rodlima78/rod6502/hw/addrdev_test.txt

A15 A14 A13 A12 A11 A10 A9 A8 CLK  RAM0 RAM1 ROM VIA IRQ ACIA LCD DEV4 DEV5 DEV6 DEV7
  0   0   0   0   0   0  0  0   0     1    1   1   1   1    1   0    1    1    1    1
  0   0   0   0   0   0  0  0   1     0    1   1   1   1    1   0    1    1    1    1
  0   1   1   1   1   1  1  1   0     1    1   1   1   1    1   0    1    1    1    1
  0   1   1   1   1   1  1  1   1     0    1   1   1   1    1   0    1    1    1    1

  1   0   0   0   0   0  0  0   0     1    1   1   1   1    1   0    1    1    1    1
  1   0   0   0   0   0  0  0   1     1    0   1   1   1    1   0    1    1    1    1
  1   0   1   1   1   1  1  1   0     1    1   1   1   1    1   0    1    1    1    1
  1   0   1   1   1   1  1  1   1     1    0   1   1   1    1   0    1    1    1    1

  1   1   0   0   0   0  0  0   0     1    1   1   0   1    1   0    1    1    1    1
  1   1   0   0   0   0  0  0   1     1    1   1   0   1    1   0    1    1    1    1

  1   1   0   0   0   0  0  1   0     1    1   1   1   0    1   0    1    1    1    1
  1   1   0   0   0   0  0  1   1     1    1   1   1   0    1   0    1    1    1    1

  1   1   0   0   0   0  1  0   0     1    1   1   1   1    0   0    1    1    1    1
  1   1   0   0   0   0  1  0   1     1    1   1   1   1    0   0    1    1    1    1

  1   1   0   0   0   0  1  1   0     1    1   1   1   1    1   0    1    1    1    1
  1   1   0   0   0   0  1  1   1     1    1   1   1   1    1   1    1    1    1    1

  1   1   0   0   1   0  0  0   0     1    1   0   1   1    1   0    1    1    1    1
  1   1   0   0   1   0  0  0   1     1    1   0   1   1    1   0    1    1    1    1

  1   1   0   1   0   0  0  0   0     1    1   0   1   1    1   0    1    1    1    1
  1   1   0   1   0   0  0  0   1     1    1   0   1   1    1   0    1    1    1    1

  1   1   1   0   0   0  0  0   0     1    1   0   1   1    1   0    1    1    1    1
  1   1   1   0   0   0  0  0   1     1    1   0   1   1    1   0    1    1    1    1

  1   1   1   1   1   1  1  1   0     1    1   0   1   1    1   0    1    1    1    1
  1   1   1   1   1   1  1  1   1     1    1   0   1   1    1   0    1    1    1    1
