rodlima78/rod6502/hw/symbols/ATF16V8B.step

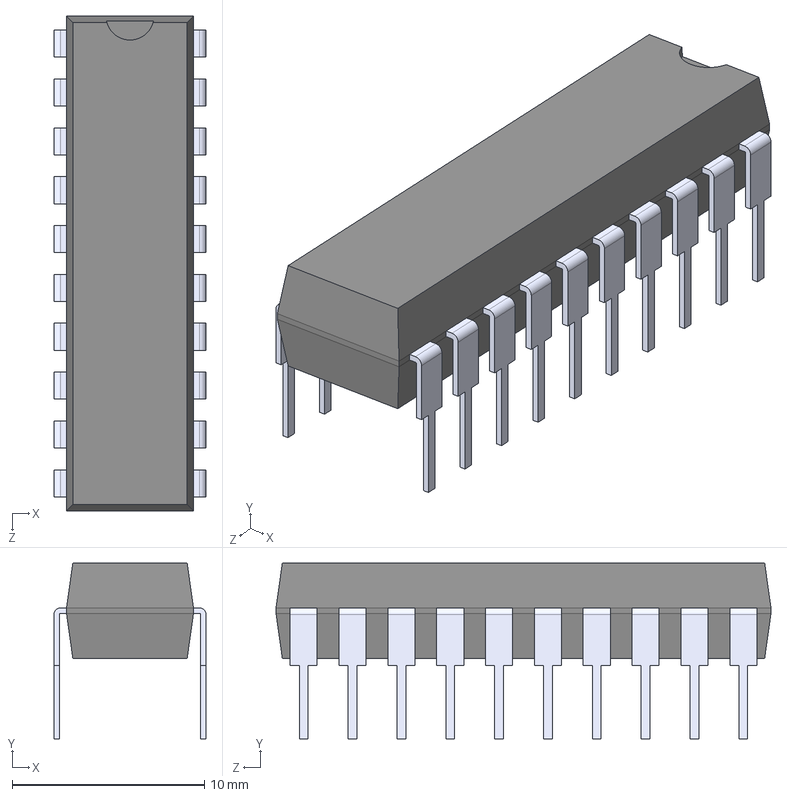
[picture p1: CAD file, 2023-03-20]
hw/symbols/ATF16V8B.step
7.90 x 9.14 x 25.7 mm
