rodlima78/rod6502/(list of files, drawings)

Other design files:
hw/addrdec.circ
hw/irq_rw.circ
hw/rw_split.circ
