rodlima78/rod6502/hw/addrdec.kicad_sch

## KiCad design hw/addrdec.kicad_sch (2023-06-03, an earlier design)

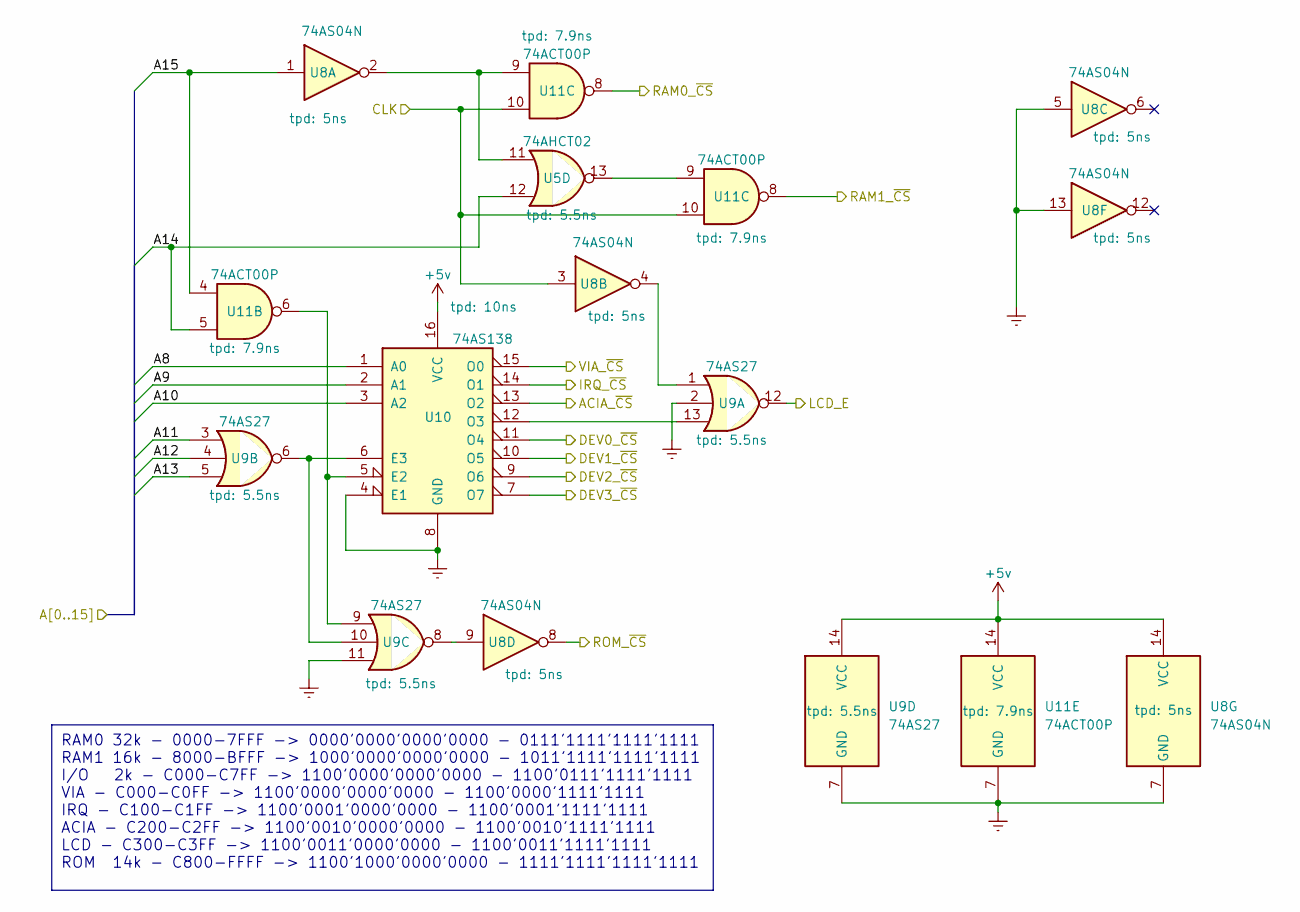
[picture p2: schematic addrdec.kicad_sch]

Parts:
U5: 74AHCT02
U8: 74AS04N
U9: 74AS27
U10: 74AS138
U11: 74ACT00P

Connections:
+5v: U8.14 (VCC), U9.14 (VCC), U10.16 (VCC), U11.14 (VCC)
A8: U10.1 (A0)
A9: U10.2 (A1)
A10: U10.3 (A2)
A11: U9.3
A12: U9.4
A13: U9.5
A14: U5.12, U11.5
A15: U8.1, U11.4
ACIA_~CS: U10.13 (O2)
CLK: U8.3, U11.10
DEV0_~CS: U10.11 (O4)
DEV1_~CS: U10.10 (O5)
DEV2_~CS: U10.9 (O6)
DEV3_~CS: U10.7 (O7)
Earth: U8.5, U8.7 (GND), U8.13, U9.2, U9.7 (GND), U9.11, U10.4 (E1), U10.8 (GND), U11.7 (GND)
IRQ_~CS: U10.14 (O1)
LCD_E: U9.12
unnamed: U8.4, U9.1
unnamed: U8.9, U9.8
unnamed: U9.9, U10.5 (E2), U11.6
unnamed: U9.6, U9.10, U10.6 (E3)
unnamed: U9.13, U10.12 (O3)
unnamed: U5.11, U5.13, U8.2, U11.9
RAM0_~CS: U11.8
RAM1_~CS: U11.8
ROM_~CS: U8.8
VIA_~CS: U10.15 (O0)

Notes on the sheet:
RAM0 32k - 0000-7FFF -> 0000'0000'0000'0000 - 0111'1111'1111'1111 RAM1 16k - 8000-BFFF -> 1000'0000'0000'0000 - 1011'1111'1111'1111 I/O 2k - C000-C7FF -> 1100'0000'0000'0000 - 1100'0111'1111'1111 VIA - C000-C0FF -> 1100'0000'0000'0000 - 1100'0000'1111'1111 IRQ - C100-C1FF -> 1100'0001'0000'0000 - 1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
