rodlima78/rod6502/hw/address_display.kicad_sch

## KiCad design hw/address_display.kicad_sch (2023-05-28, an earlier design)

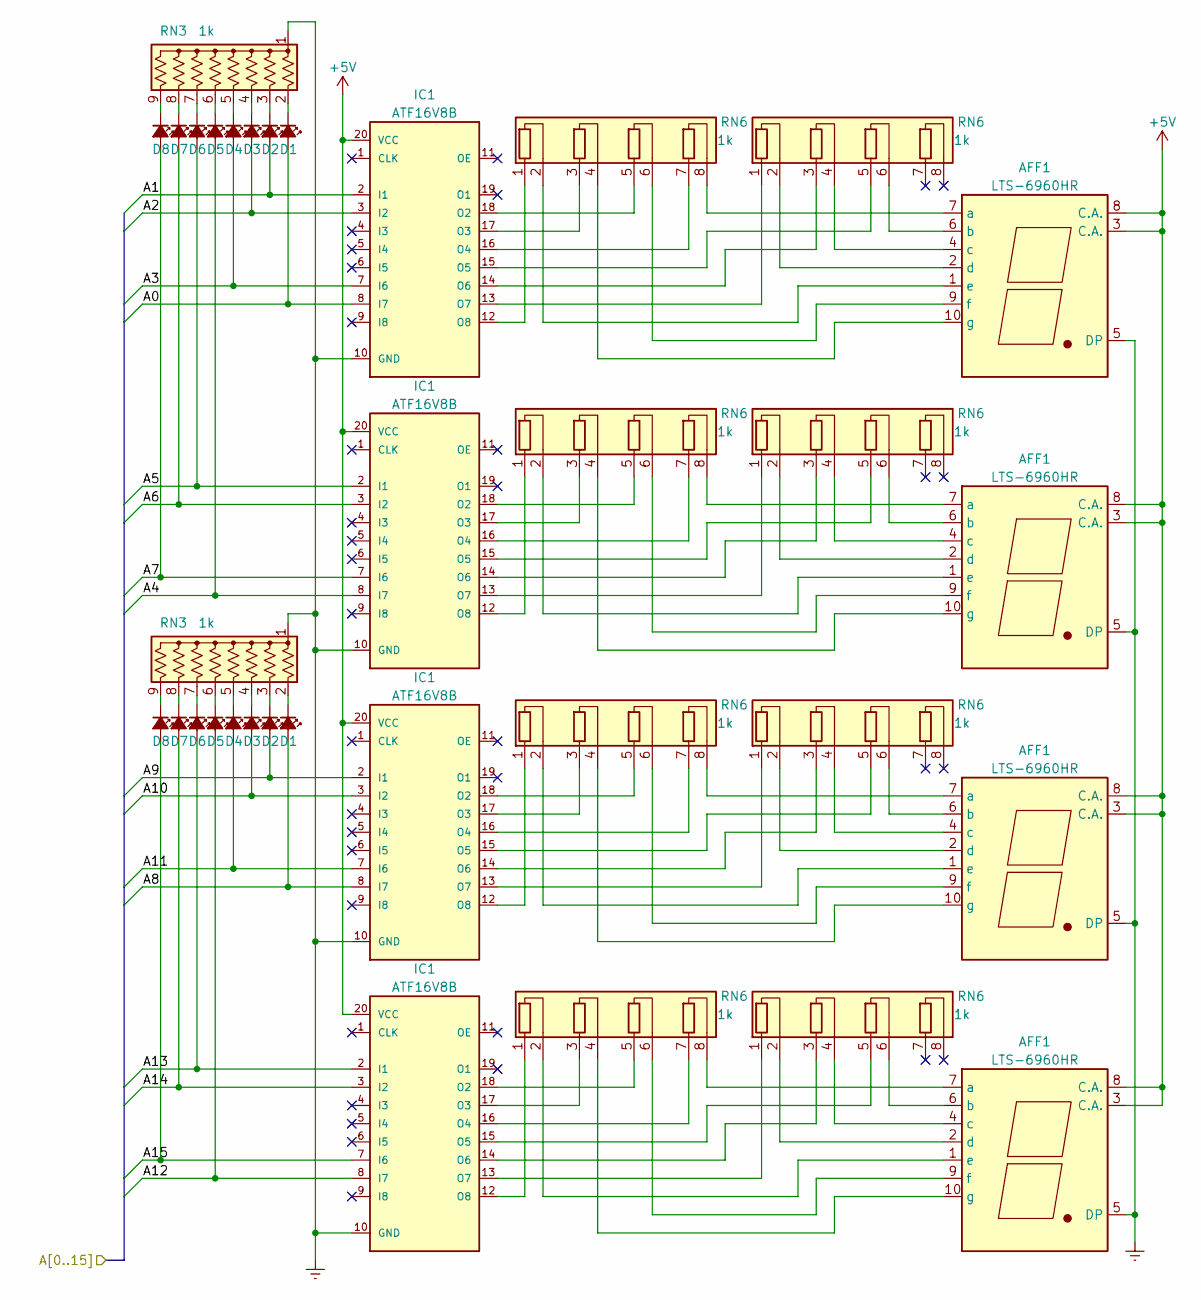
[picture p3: schematic address_display.kicad_sch]

Parts:
AFF1: LTS-6960HR; 7SegmentLED_LTS6760_LTS6780
D1, D2, D3, D4, D5, D6, D7, D8: LED_Small_Filled
IC1: ATF16V8B
RN3: 1k; R_Array_SIP9
RN6: 1k; R_Array_SIP8

Connections:
+5V: AFF1.3 (C.A.), AFF1.8 (C.A.), IC1.20 (VCC)
A0: D1.2 (A), IC1.8 (I7)
A1: D2.2 (A), IC1.2 (I1)
A2: D3.2 (A), IC1.3 (I2)
A3: D4.2 (A), IC1.7 (I6)
A4: D5.2 (A), IC1.8 (I7)
A5: D6.2 (A), IC1.2 (I1)
A6: D7.2 (A), IC1.3 (I2)
A7: D8.2 (A), IC1.7 (I6)
A8: D1.2 (A), IC1.8 (I7)
A9: D2.2 (A), IC1.2 (I1)
A10: D3.2 (A), IC1.3 (I2)
A11: D4.2 (A), IC1.7 (I6)
A12: D5.2 (A), IC1.8 (I7)
A13: D6.2 (A), IC1.2 (I1)
A14: D7.2 (A), IC1.3 (I2)
A15: D8.2 (A), IC1.7 (I6)
Earth: AFF1.5 (DP), IC1.10 (GND), RN3.1 (common)
unnamed: AFF1.1 (e), RN6.2 (R1.2)
unnamed: AFF1.2 (d), RN6.2 (R1.2)
unnamed: AFF1.4 (c), RN6.4 (R2.2)
unnamed: AFF1.6 (b), RN6.6 (R3.2)
unnamed: AFF1.7 (a), RN6.8 (R4.2)
unnamed: AFF1.9 (f), RN6.6 (R3.2)
unnamed: AFF1.10 (g), RN6.4 (R2.2)
unnamed: D1.1 (K), RN3.2 (R1)
unnamed: D2.1 (K), RN3.3 (R2)
unnamed: D3.1 (K), RN3.4 (R3)
unnamed: D4.1 (K), RN3.5 (R4)
unnamed: D5.1 (K), RN3.6 (R5)
unnamed: D6.1 (K), RN3.7 (R6)
unnamed: D7.1 (K), RN3.8 (R7)
unnamed: D8.1 (K), RN3.9 (R8)
unnamed: IC1.12 (O8), RN6.1 (R1.1)
unnamed: IC1.13 (O7), RN6.1 (R1.1)
unnamed: IC1.14 (O6), RN6.3 (R2.1)
unnamed: IC1.15 (O5), RN6.5 (R3.1)
unnamed: IC1.16 (O4), RN6.7 (R4.1)
unnamed: IC1.17 (O3), RN6.3 (R2.1)
unnamed: IC1.18 (O2), RN6.5 (R3.1)
