rodlima78/rod6502/hw/ctrl_display.kicad_sch

## KiCad design hw/ctrl_display.kicad_sch (2023-05-28, an earlier design)

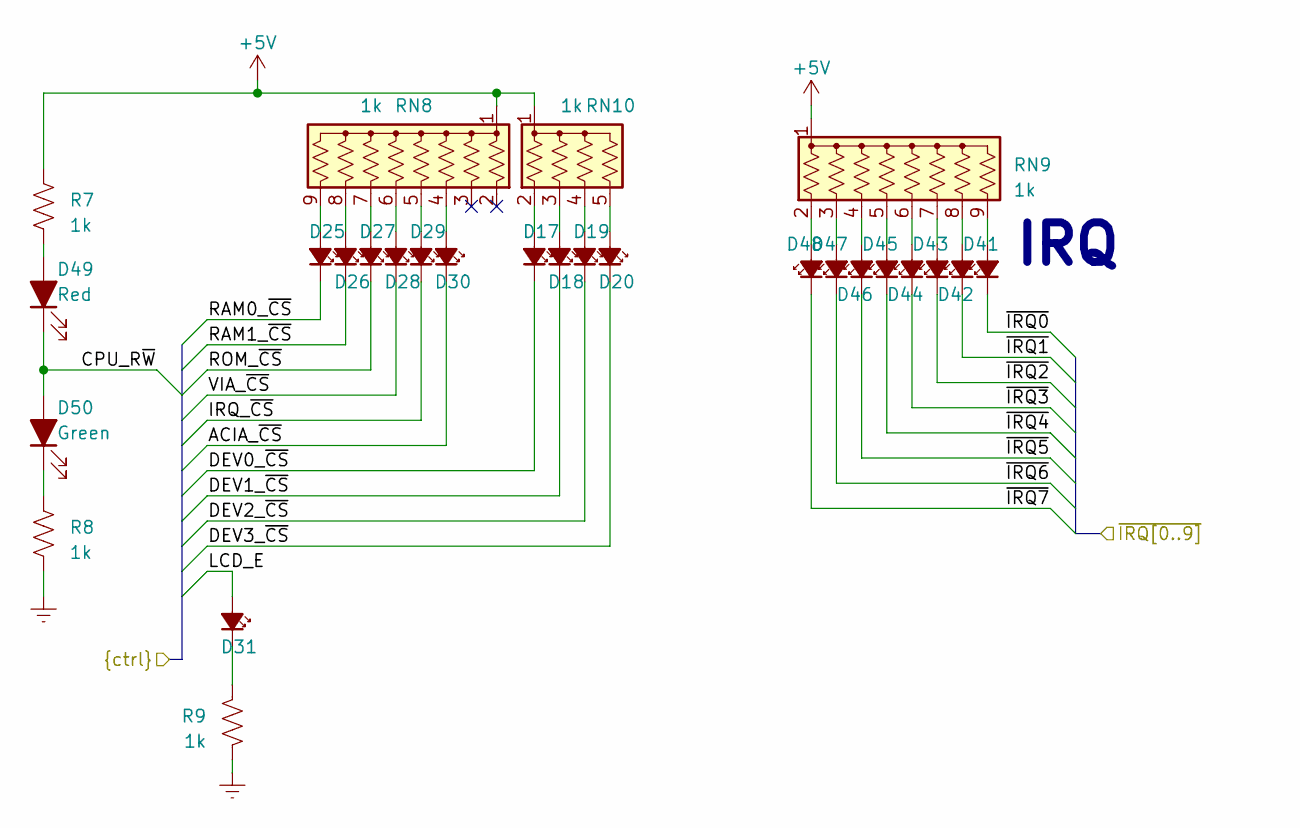
[picture p4: schematic ctrl_display.kicad_sch]

Parts:
D17, D18, D19, D20, D25, D26, D27, D28, D29, D30, D31, D41, D42, D43, D44, D45, D46, D47, D48: LED_Small_Filled
D49: Red
D50: Green
R7, R8, R9: 1k
RN8, RN9: 1k; R_Array_SIP9
RN10: 1k; R_Array_SIP5

Connections:
+5V: R7.1, RN8.1 (common), RN9.1 (common), RN10.1 (common)
ACIA_~CS: D30.1 (K)
CPU_R~W: D49.1 (K), D50.2 (A)
DEV0_~CS: D17.1 (K)
DEV1_~CS: D18.1 (K)
DEV2_~CS: D19.1 (K)
DEV3_~CS: D20.1 (K)
Earth: R8.2, R9.2
IRQ_~CS: D29.1 (K)
LCD_E: D31.2 (A)
unnamed: D17.2 (A), RN10.2 (R1)
unnamed: D18.2 (A), RN10.3 (R2)
unnamed: D19.2 (A), RN10.4 (R3)
unnamed: D20.2 (A), RN10.5 (R4)
unnamed: D25.2 (A), RN8.9 (R8)
unnamed: D26.2 (A), RN8.8 (R7)
unnamed: D27.2 (A), RN8.7 (R6)
unnamed: D28.2 (A), RN8.6 (R5)
unnamed: D29.2 (A), RN8.5 (R4)
unnamed: D30.2 (A), RN8.4 (R3)
unnamed: D31.1 (K), R9.1
unnamed: D41.2 (A), RN9.9 (R8)
unnamed: D42.2 (A), RN9.8 (R7)
unnamed: D43.2 (A), RN9.7 (R6)
unnamed: D44.2 (A), RN9.6 (R5)
unnamed: D45.2 (A), RN9.5 (R4)
unnamed: D46.2 (A), RN9.4 (R3)
unnamed: D47.2 (A), RN9.3 (R2)
unnamed: D48.2 (A), RN9.2 (R1)
unnamed: D49.2 (A), R7.2
unnamed: D50.1 (K), R8.1
RAM0_~CS: D25.1 (K)
RAM1_~CS: D26.1 (K)
ROM_~CS: D27.1 (K)
VIA_~CS: D28.1 (K)
~IRQ0: D41.1 (K)
~IRQ1: D42.1 (K)
~IRQ2: D43.1 (K)
~IRQ3: D44.1 (K)
~IRQ4: D45.1 (K)
~IRQ5: D46.1 (K)
~IRQ6: D47.1 (K)
~IRQ7: D48.1 (K)

Notes on the sheet:
IRQ
