rodlima78/rod6502/hw/io.kicad_sch

## KiCad design hw/io.kicad_sch (2023-05-28, an earlier design)

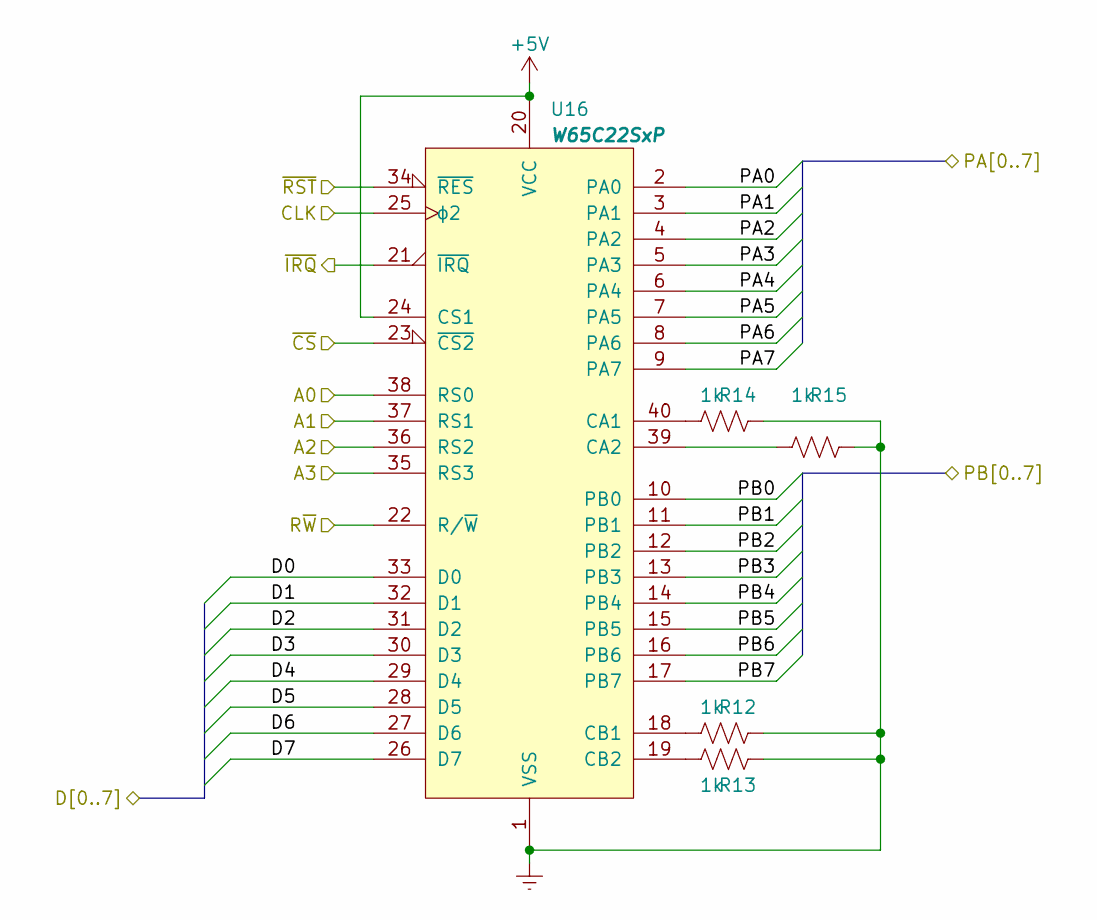
[picture p5: schematic io.kicad_sch]

Parts:
R12, R13, R14, R15: 1k
U16: W65C22SxP; DIP-40_W15.24mm

Connections:
+5V: U16.20 (VCC), U16.24 (CS1)
A0: U16.38 (RS0)
A1: U16.37 (RS1)
A2: U16.36 (RS2)
A3: U16.35 (RS3)
CLK: U16.25 (ϕ2)
D0: U16.33 (D0)
D1: U16.32 (D1)
D2: U16.31 (D2)
D3: U16.30 (D3)
D4: U16.29 (D4)
D5: U16.28 (D5)
D6: U16.27 (D6)
D7: U16.26 (D7)
Earth: R12.2, R13.2, R14.2, R15.2, U16.1 (VSS)
unnamed: R12.1, U16.18 (CB1)
unnamed: R13.1, U16.19 (CB2)
unnamed: R14.1, U16.40 (CA1)
unnamed: R15.1, U16.39 (CA2)
PA0: U16.2 (PA0)
PA1: U16.3 (PA1)
PA2: U16.4 (PA2)
PA3: U16.5 (PA3)
PA4: U16.6 (PA4)
PA5: U16.7 (PA5)
PA6: U16.8 (PA6)
PA7: U16.9 (PA7)
PB0: U16.10 (PB0)
PB1: U16.11 (PB1)
PB2: U16.12 (PB2)
PB3: U16.13 (PB3)
PB4: U16.14 (PB4)
PB5: U16.15 (PB5)
PB6: U16.16 (PB6)
PB7: U16.17 (PB7)
R~W: U16.22 (R/~W)
~CS: U16.23 (~CS2)
~IRQ: U16.21 (~IRQ)
~RST: U16.34 (~RES)
