rodlima78/rod6502/hw/irq.kicad_sch

## KiCad design hw/irq.kicad_sch (2023-06-03, an earlier design)

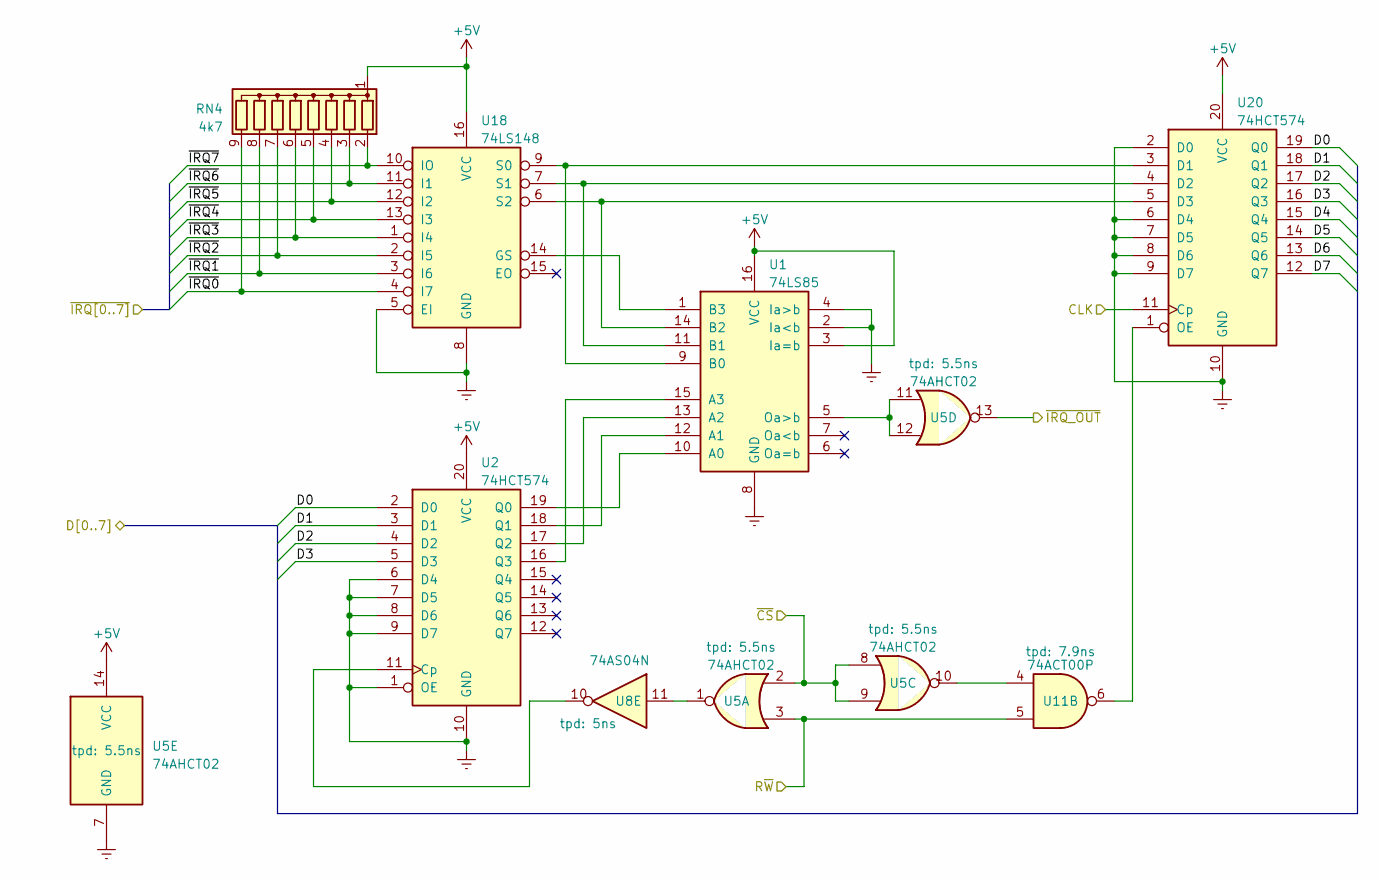
[picture p6: schematic irq.kicad_sch]

Parts:
RN4: 4k7; R_Array_SIP9
U1: 74LS85
U2, U20: 74HCT574
U5: 74AHCT02
U8: 74AS04N
U11: 74ACT00P
U18: 74LS148

Connections:
+5V: RN4.1 (common), U1.3 (Ia=b), U1.16 (VCC), U2.20 (VCC), U5.14 (VCC), U18.16 (VCC), U20.20 (VCC)
CLK: U20.11 (Cp)
D0: U2.2 (D0), U20.19 (Q0)
D1: U2.3 (D1), U20.18 (Q1)
D2: U2.4 (D2), U20.17 (Q2)
D3: U2.5 (D3), U20.16 (Q3)
D4: U20.15 (Q4)
D5: U20.14 (Q5)
D6: U20.13 (Q6)
D7: U20.12 (Q7)
Earth: U1.2 (Ia<b), U1.4 (Ia>b), U1.8 (GND), U2.1 (OE), U2.6 (D4), U2.7 (D5), U2.8 (D6), U2.9 (D7), U2.10 (GND), U5.7 (GND), U18.5 (EI), U18.8 (GND), U20.2 (D0), U20.6 (D4), U20.7 (D5), U20.8 (D6), U20.9 (D7), U20.10 (GND)
unnamed: U1.1 (B3), U18.14 (GS)
unnamed: U1.5 (Oa>b), U5.11, U5.12
unnamed: U1.9 (B0), U18.9 (S0), U20.3 (D1)
unnamed: U1.10 (A0), U2.19 (Q0)
unnamed: U1.11 (B1), U18.7 (S1), U20.4 (D2)
unnamed: U1.12 (A1), U2.18 (Q1)
unnamed: U1.13 (A2), U2.17 (Q2)
unnamed: U1.14 (B2), U18.6 (S2), U20.5 (D3)
unnamed: U1.15 (A3), U2.16 (Q3)
unnamed: U2.11 (Cp), U8.10
unnamed: U5.1, U8.11
unnamed: U5.10, U11.4
unnamed: U11.6, U20.1 (OE)
R~W: U5.3, U11.5
~CS: U5.2, U5.8, U5.9
~IRQ0: RN4.9 (R8), U18.4 (I7)
~IRQ1: RN4.8 (R7), U18.3 (I6)
~IRQ2: RN4.7 (R6), U18.2 (I5)
~IRQ3: RN4.6 (R5), U18.1 (I4)
~IRQ4: RN4.5 (R4), U18.13 (I3)
~IRQ5: RN4.4 (R3), U18.12 (I2)
~IRQ6: RN4.3 (R2), U18.11 (I1)
~IRQ7: RN4.2 (R1), U18.10 (IO)
~IRQ_OUT: U5.13
