rodlima78/rod6502/hw/lcd.kicad_sch

## KiCad design hw/lcd.kicad_sch (2023-05-28, an earlier design)

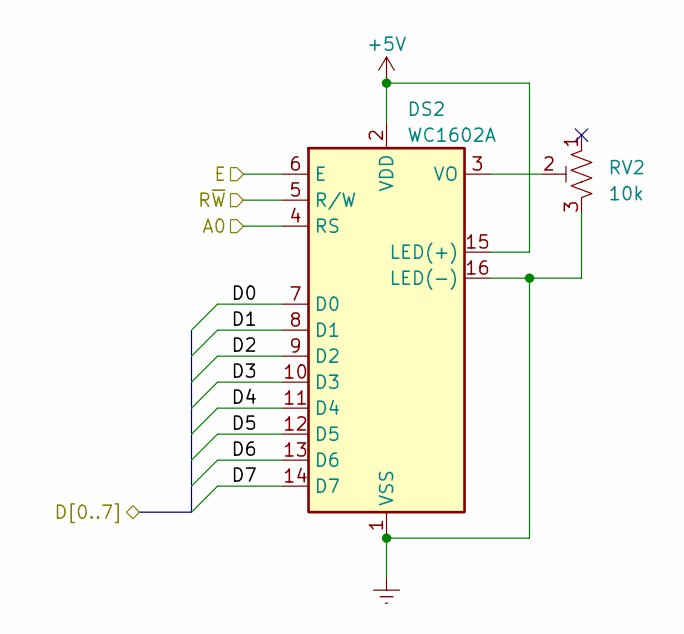
[picture p7: schematic lcd.kicad_sch]

Parts:
DS2: WC1602A; HY1602E
RV2: 10k

Connections:
+5V: DS2.2 (VDD), DS2.15 (LED(+))
A0: DS2.4 (RS)
D0: DS2.7 (D0)
D1: DS2.8 (D1)
D2: DS2.9 (D2)
D3: DS2.10 (D3)
D4: DS2.11 (D4)
D5: DS2.12 (D5)
D6: DS2.13 (D6)
D7: DS2.14 (D7)
E: DS2.6 (E)
Earth: DS2.1 (VSS), DS2.16 (LED(-)), RV2.3
unnamed: DS2.3 (VO), RV2.2
R~W: DS2.5 (R/W)
