rodlima78/rod6502/hw/leds.kicad_sch

## KiCad design hw/leds.kicad_sch (2023-03-20)

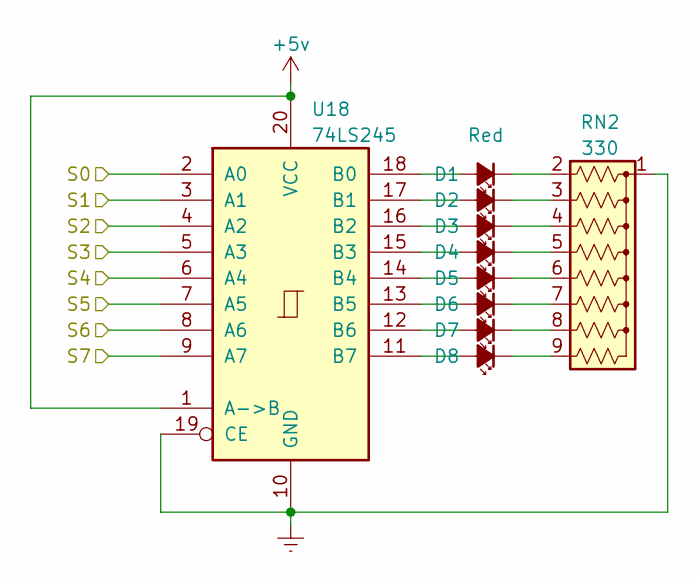
[picture p8: schematic leds.kicad_sch]

Parts:
D1, D2, D3, D4, D5, D6, D7, D8: Red
RN2: 330; R_Array_SIP9
U18: 74LS245

Connections:
+5v: U18.1 (A->B), U18.20 (VCC)
Earth: RN2.1 (common), U18.10 (GND), U18.19 (CE)
unnamed: D1.1 (K), RN2.2 (R1)
unnamed: D1.2 (A), U18.18 (B0)
unnamed: D2.1 (K), RN2.3 (R2)
unnamed: D2.2 (A), U18.17 (B1)
unnamed: D3.1 (K), RN2.4 (R3)
unnamed: D3.2 (A), U18.16 (B2)
unnamed: D4.1 (K), RN2.5 (R4)
unnamed: D4.2 (A), U18.15 (B3)
unnamed: D5.1 (K), RN2.6 (R5)
unnamed: D5.2 (A), U18.14 (B4)
unnamed: D6.1 (K), RN2.7 (R6)
unnamed: D6.2 (A), U18.13 (B5)
unnamed: D7.1 (K), RN2.8 (R7)
unnamed: D7.2 (A), U18.12 (B6)
unnamed: D8.1 (K), RN2.9 (R8)
unnamed: D8.2 (A), U18.11 (B7)
S0: U18.2 (A0)
S1: U18.3 (A1)
S2: U18.4 (A2)
S3: U18.5 (A3)
S4: U18.6 (A4)
S5: U18.7 (A5)
S6: U18.8 (A6)
S7: U18.9 (A7)
