rodlima78/rod6502/hw/leds_inv.kicad_sch

## KiCad design hw/leds_inv.kicad_sch (2023-03-20)

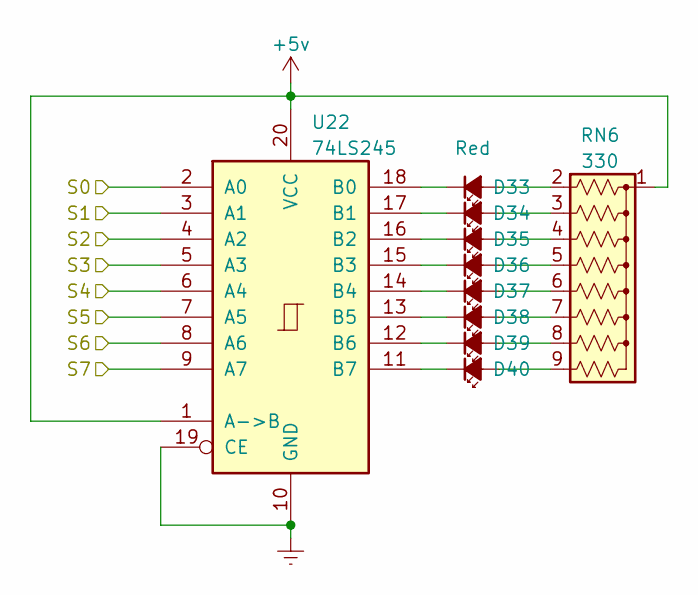
[picture p9: schematic leds_inv.kicad_sch]

Parts:
D33, D34, D35, D36, D37, D38, D39, D40: Red
RN6: 330; R_Array_SIP9
U22: 74LS245

Connections:
+5v: RN6.1 (common), U22.1 (A->B), U22.20 (VCC)
Earth: U22.10 (GND), U22.19 (CE)
unnamed: D33.1 (K), U22.18 (B0)
unnamed: D33.2 (A), RN6.2 (R1)
unnamed: D34.1 (K), U22.17 (B1)
unnamed: D34.2 (A), RN6.3 (R2)
unnamed: D35.1 (K), U22.16 (B2)
unnamed: D35.2 (A), RN6.4 (R3)
unnamed: D36.1 (K), U22.15 (B3)
unnamed: D36.2 (A), RN6.5 (R4)
unnamed: D37.1 (K), U22.14 (B4)
unnamed: D37.2 (A), RN6.6 (R5)
unnamed: D38.1 (K), U22.13 (B5)
unnamed: D38.2 (A), RN6.7 (R6)
unnamed: D39.1 (K), U22.12 (B6)
unnamed: D39.2 (A), RN6.8 (R7)
unnamed: D40.1 (K), U22.11 (B7)
unnamed: D40.2 (A), RN6.9 (R8)
S0: U22.2 (A0)
S1: U22.3 (A1)
S2: U22.4 (A2)
S3: U22.5 (A3)
S4: U22.6 (A4)
S5: U22.7 (A5)
S6: U22.8 (A6)
S7: U22.9 (A7)
