rodlima78/rod6502/hw/lvlconv4.kicad_sch

## KiCad design hw/lvlconv4.kicad_sch (2023-05-28, an earlier design)

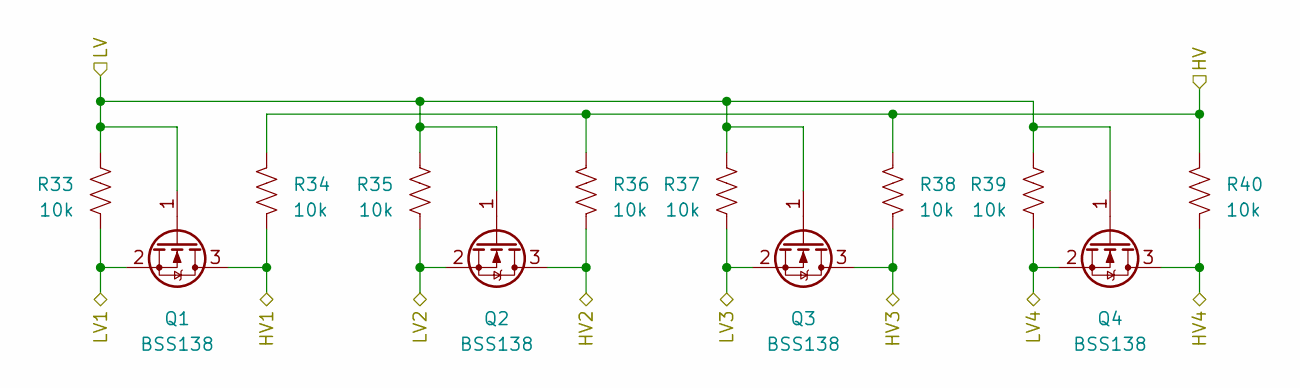
[picture p10: schematic lvlconv4.kicad_sch]

Parts:
Q1, Q2, Q3, Q4: BSS138; SOT-23
R33, R34, R35, R36, R37, R38, R39, R40: 10k

Connections:
HV: R34.1, R36.1, R38.1, R40.1
HV1: Q1.3 (D), R34.2
HV2: Q2.3 (D), R36.2
HV3: Q3.3 (D), R38.2
HV4: Q4.3 (D), R40.2
LV: Q1.1 (G), Q2.1 (G), Q3.1 (G), Q4.1 (G), R33.1, R35.1, R37.1, R39.1
LV1: Q1.2 (S), R33.2
LV2: Q2.2 (S), R35.2
LV3: Q3.2 (S), R37.2
LV4: Q4.2 (S), R39.2
