rodlima78/rod6502/hw/mem.kicad_sch

## KiCad design hw/mem.kicad_sch (2023-06-03, an earlier design)

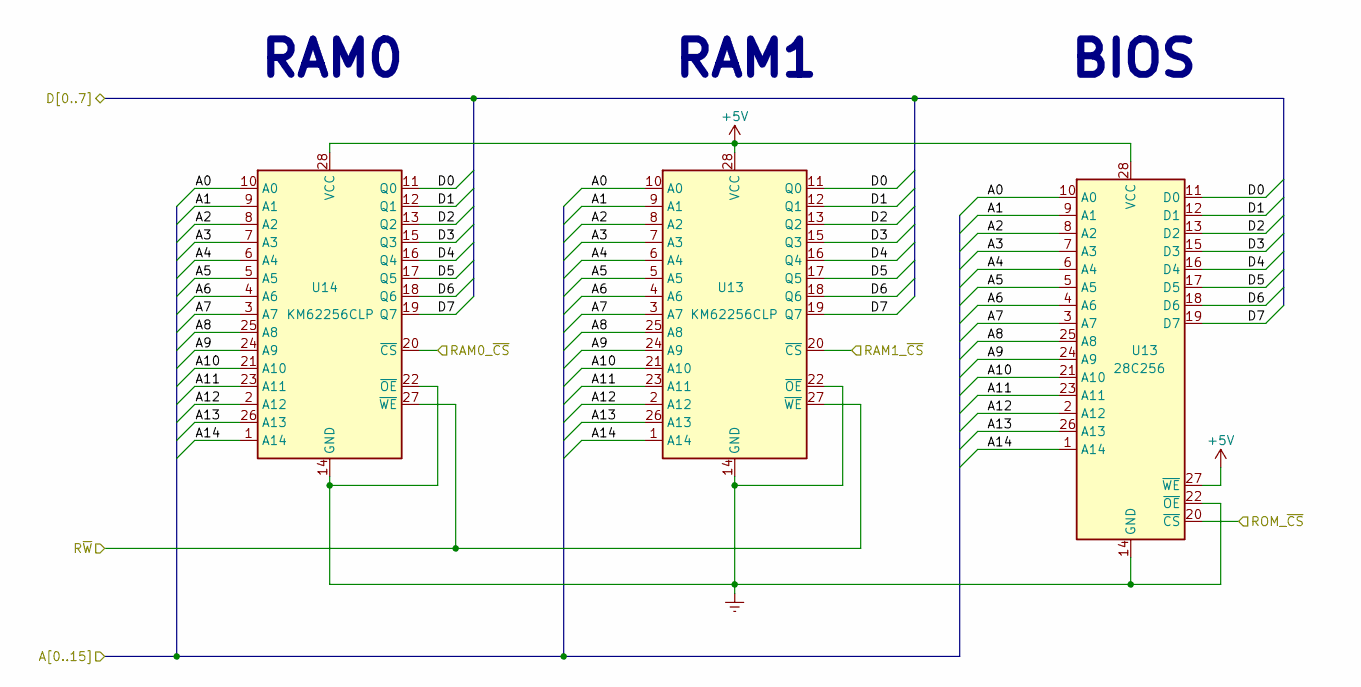
[picture p11: schematic mem.kicad_sch]

Parts:
U13, U14: KM62256CLP; DIP-28_W15.24mm

Connections:
+5V: U13.27 (~WE), U13.28 (VCC), U14.28 (VCC)
A0: U13.10 (A0), U14.10 (A0)
A1: U13.9 (A1), U14.9 (A1)
A2: U13.8 (A2), U14.8 (A2)
A3: U13.7 (A3), U14.7 (A3)
A4: U13.6 (A4), U14.6 (A4)
A5: U13.5 (A5), U14.5 (A5)
A6: U13.4 (A6), U14.4 (A6)
A7: U13.3 (A7), U14.3 (A7)
A8: U13.25 (A8), U14.25 (A8)
A9: U13.24 (A9), U14.24 (A9)
A10: U13.21 (A10), U14.21 (A10)
A11: U13.23 (A11), U14.23 (A11)
A12: U13.2 (A12), U14.2 (A12)
A13: U13.26 (A13), U14.26 (A13)
A14: U13.1 (A14), U14.1 (A14)
D0: U13.11 (D0), U14.11 (Q0)
D1: U13.12 (D1), U14.12 (Q1)
D2: U13.13 (D2), U14.13 (Q2)
D3: U13.15 (D3), U14.15 (Q3)
D4: U13.16 (D4), U14.16 (Q4)
D5: U13.17 (D5), U14.17 (Q5)
D6: U13.18 (D6), U14.18 (Q6)
D7: U13.19 (D7), U14.19 (Q7)
Earth: U13.14 (GND), U13.22 (~OE), U14.14 (GND), U14.22 (~OE)
RAM0_~CS: U14.20 (~CS)
RAM1_~CS: U13.20 (~CS)
ROM_~CS: U13.20 (~CS)
R~W: U13.27 (~WE), U14.27 (~WE)

Notes on the sheet:
RAM1
RAM0
BIOS
