rodlima78/rod6502/hw/reset.kicad_sch

## KiCad design hw/reset.kicad_sch (2023-05-28, an earlier design)

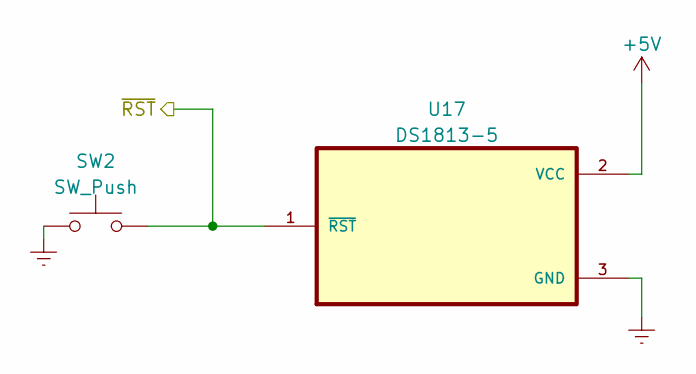
[picture p12: schematic reset.kicad_sch]

Parts:
SW2: SW_Push
U17: DS1813-5; TO92127P495H695-3

Connections:
+5V: U17.2 (VCC)
Earth: SW2.2, U17.3 (GND)
~RST: SW2.1, U17.1 (~RST)
