rodlima78/rod6502/hw/rod6502.kicad_sch

## KiCad design hw/rod6502.kicad_sch (2023-06-03, an earlier design)

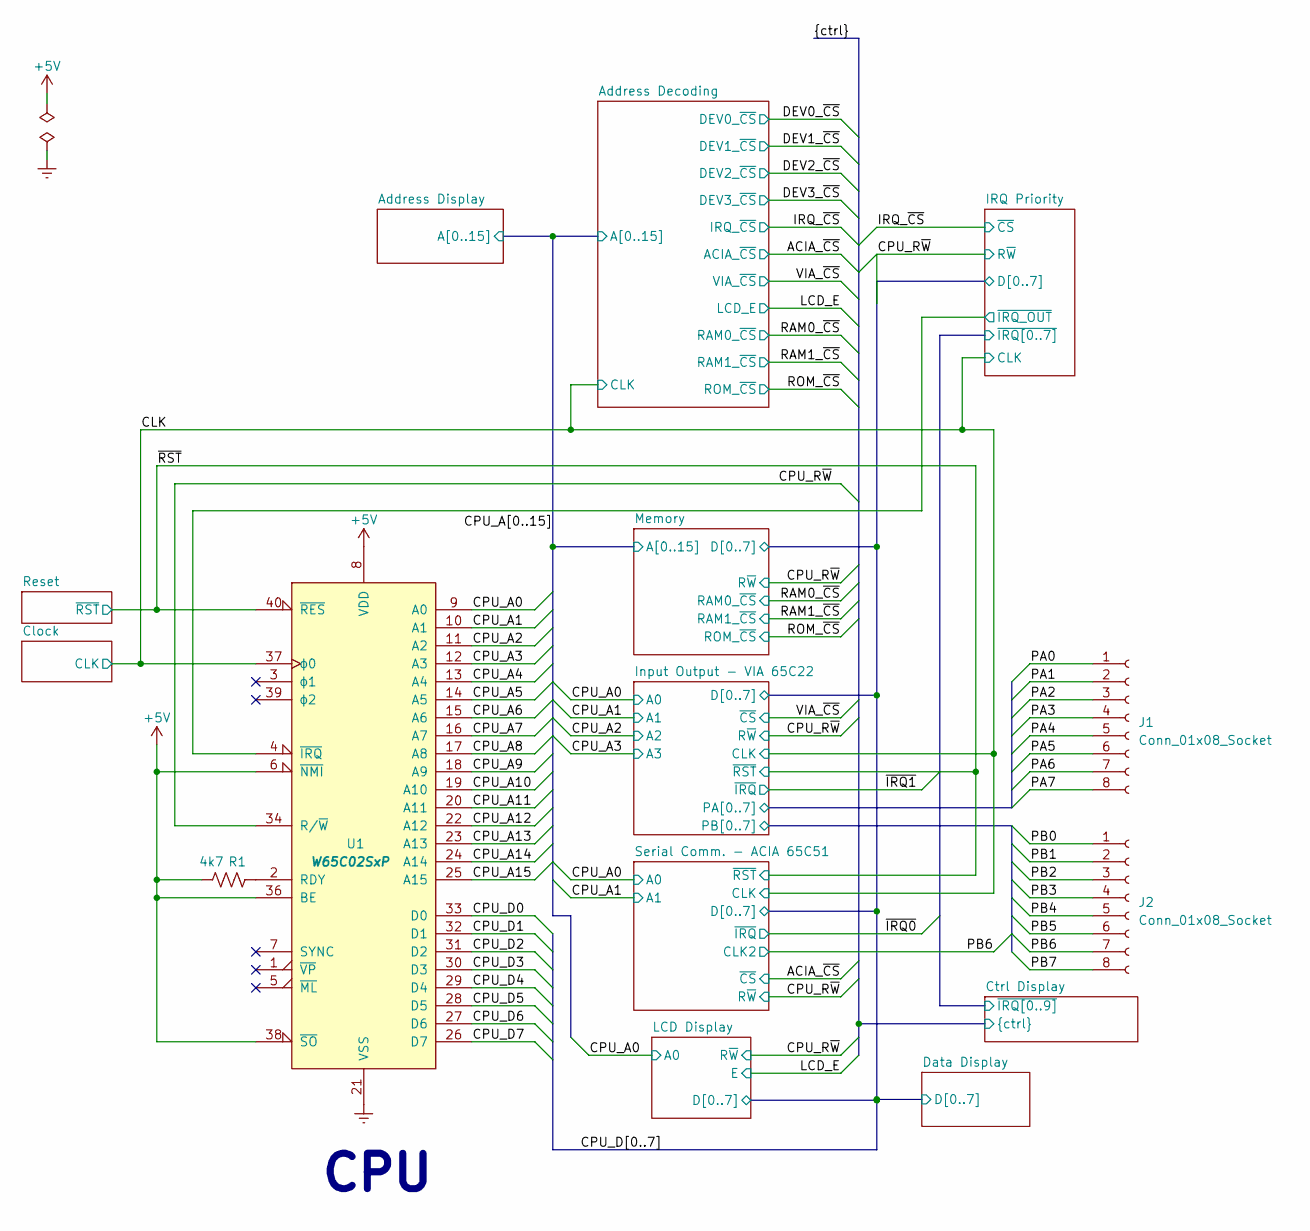
[picture p13: schematic rod6502.kicad_sch]

Parts:
J1, J2: Conn_01x08_Socket
R1: 4k7
U1: W65C02SxP; DIP-40_W15.24mm

Connections:
+5V: R1.1, U1.6 (~NMI), U1.8 (VDD), U1.36 (BE), U1.38 (~SO)
CLK: U1.37 (ϕ0)
CPU_A0: U1.9 (A0)
CPU_A1: U1.10 (A1)
CPU_A2: U1.11 (A2)
CPU_A3: U1.12 (A3)
CPU_A4: U1.13 (A4)
CPU_A5: U1.14 (A5)
CPU_A6: U1.15 (A6)
CPU_A7: U1.16 (A7)
CPU_A8: U1.17 (A8)
CPU_A9: U1.18 (A9)
CPU_A10: U1.19 (A10)
CPU_A11: U1.20 (A11)
CPU_A12: U1.22 (A12)
CPU_A13: U1.23 (A13)
CPU_A14: U1.24 (A14)
CPU_A15: U1.25 (A15)
CPU_D0: U1.33 (D0)
CPU_D1: U1.32 (D1)
CPU_D2: U1.31 (D2)
CPU_D3: U1.30 (D3)
CPU_D4: U1.29 (D4)
CPU_D5: U1.28 (D5)
CPU_D6: U1.27 (D6)
CPU_D7: U1.26 (D7)
CPU_R~W: U1.34 (R/~W)
Earth: U1.21 (VSS)
unnamed: R1.2, U1.2 (RDY)
PA0: J1.1
PA1: J1.2
PA2: J1.3
PA3: J1.4
PA4: J1.5
PA5: J1.6
PA6: J1.7
PA7: J1.8
PB0: J2.1
PB1: J2.2
PB2: J2.3
PB3: J2.4
PB4: J2.5
PB5: J2.6
PB6: J2.7
PB7: J2.8
~IRQ_OUT: U1.4 (~IRQ)
~RST: U1.40 (~RES)

Notes on the sheet:
CPU
