rodlima78/rod6502/hw/serialcomm.kicad_sch

## KiCad design hw/serialcomm.kicad_sch (2023-05-28, an earlier design)

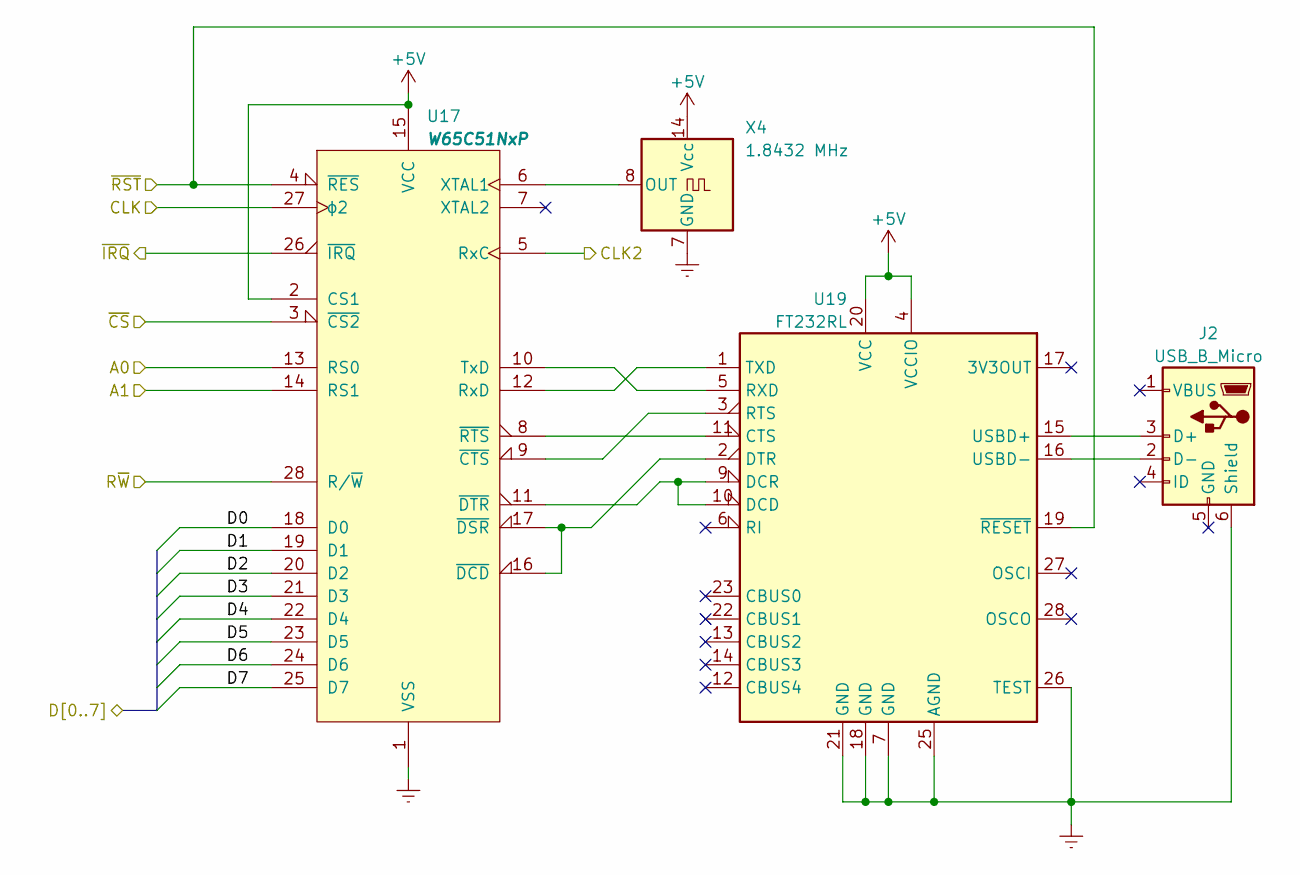
[picture p14: schematic serialcomm.kicad_sch]

Parts:
J2: USB_B_Micro
U17: W65C51NxP; DIP-28_W15.24mm
U19: FT232RL; SSOP-28_5.3x10.2mm_P0.65mm
X4: 1.8432 MHz; Oscillator_DIP-14

Connections:
+5V: U17.2 (CS1), U17.15 (VCC), U19.4 (VCCIO), U19.20 (VCC), X4.14 (Vcc)
A0: U17.13 (RS0)
A1: U17.14 (RS1)
CLK: U17.27 (ϕ2)
CLK2: U17.5 (RxC)
D0: U17.18 (D0)
D1: U17.19 (D1)
D2: U17.20 (D2)
D3: U17.21 (D3)
D4: U17.22 (D4)
D5: U17.23 (D5)
D6: U17.24 (D6)
D7: U17.25 (D7)
Earth: J2.6 (Shield), U17.1 (VSS), U19.7 (GND), U19.18 (GND), U19.21 (GND), U19.25 (AGND), U19.26 (TEST), X4.7 (GND)
unnamed: J2.2 (D-), U19.16 (USBD-)
unnamed: J2.3 (D+), U19.15 (USBD+)
unnamed: U17.6 (XTAL1), X4.8 (OUT)
unnamed: U17.8 (~RTS), U19.11 (CTS)
unnamed: U17.9 (~CTS), U19.3 (RTS)
unnamed: U17.10 (TxD), U19.5 (RXD)
unnamed: U17.11 (~DTR), U19.9 (DCR), U19.10 (DCD)
unnamed: U17.12 (RxD), U19.1 (TXD)
unnamed: U17.16 (~DCD), U17.17 (~DSR), U19.2 (DTR)
R~W: U17.28 (R/~W)
~CS: U17.3 (~CS2)
~IRQ: U17.26 (~IRQ)
~RST: U17.4 (~RES), U19.19 (~RESET)
