rodlima78/rod6502/hw/vera.kicad_sch.kicad_sch

## KiCad design hw/vera.kicad_sch.kicad_sch (2023-06-03, an earlier design)

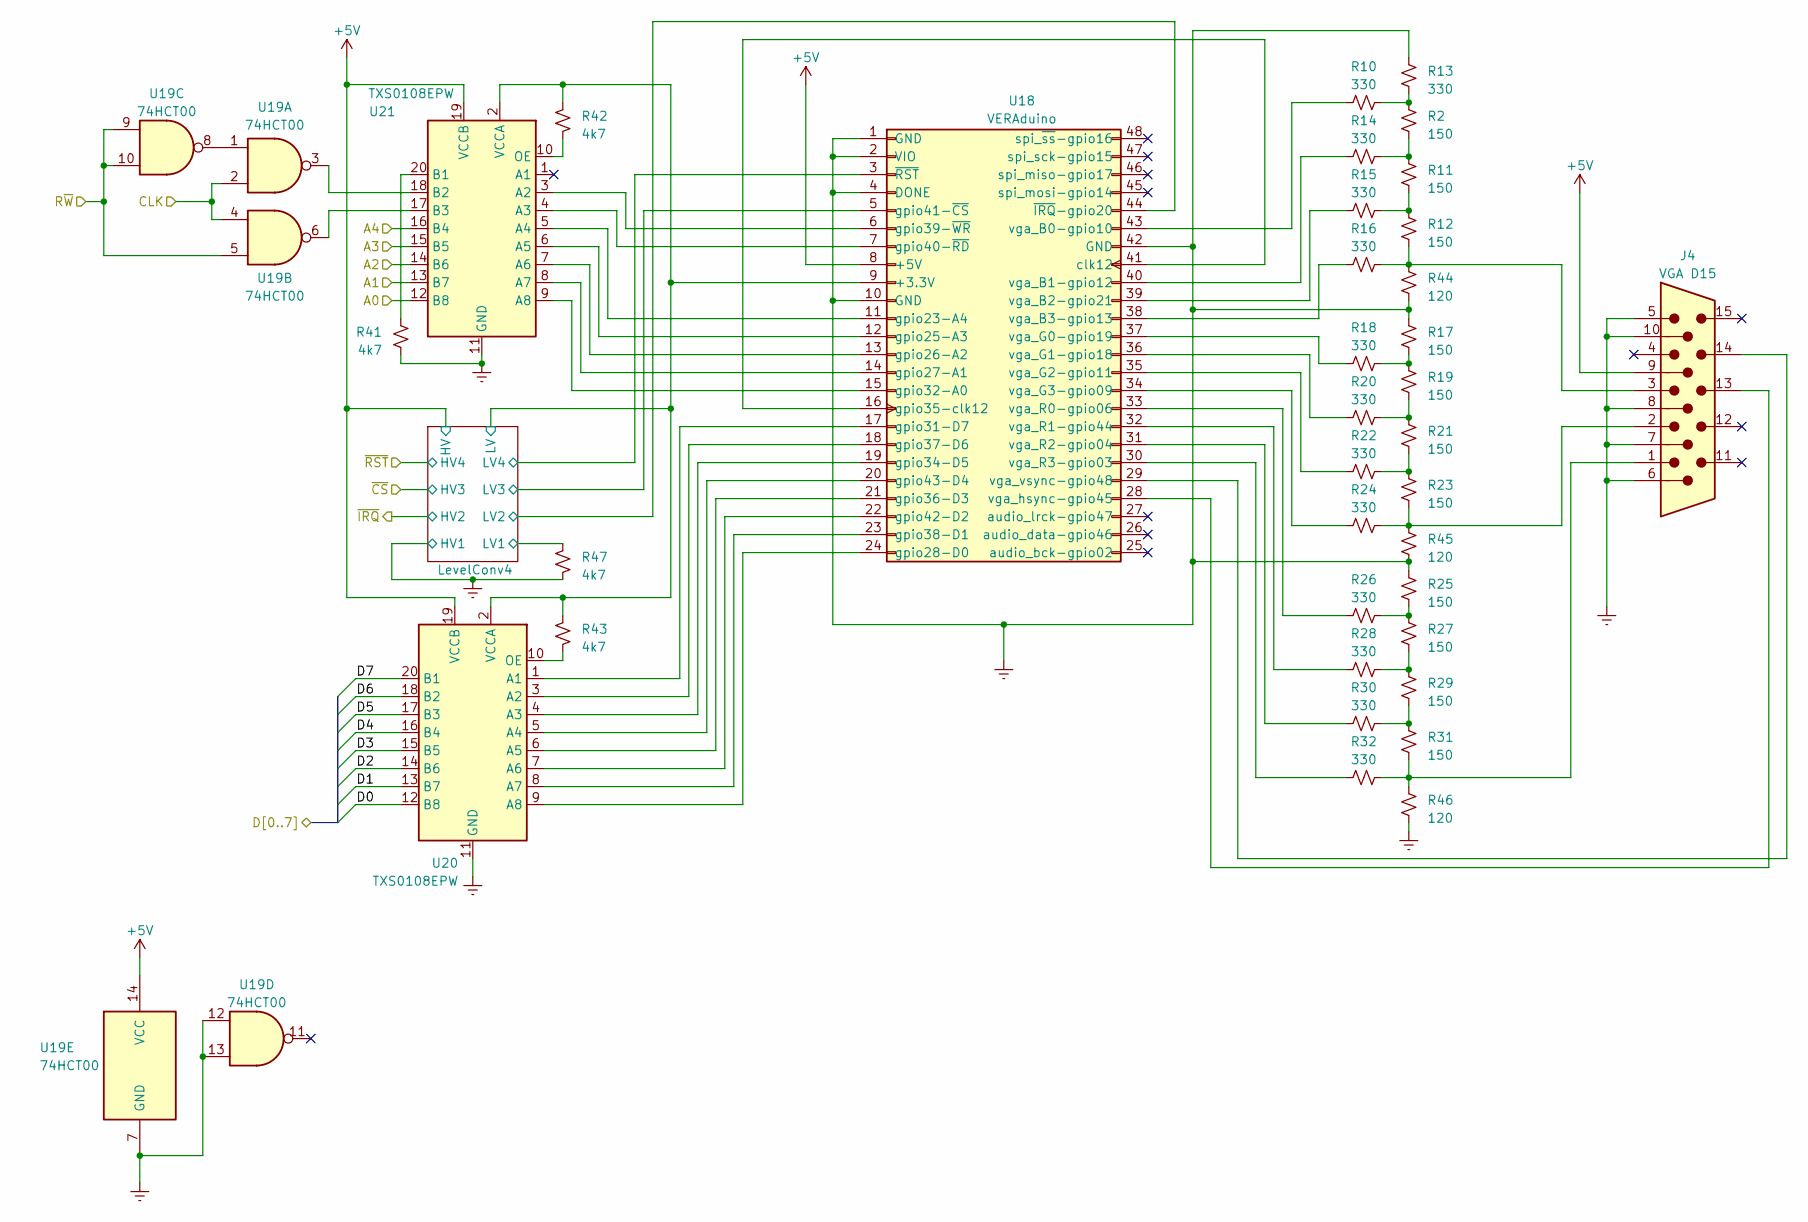
[picture p15: schematic vera.kicad_sch.kicad_sch]

Parts:
J4: VGA D15
R2, R11, R12, R17, R19, R21, R23, R25, R27, R29, R31: 150
R10, R13, R14, R15, R16, R18, R20, R22, R24, R26, R28, R30, R32: 330
R41, R42, R43, R47: 4k7
R44, R45, R46: 120
U18: VERAduino
U19: 74HCT00
U20, U21: TXS0108EPW; TSSOP-20_4.4x6.5mm_P0.65mm

Connections:
+5V: J4.9, U18.8 (+5V), U19.14 (VCC), U20.19 (VCCB), U21.19 (VCCB)
A0: U21.12 (B8)
A1: U21.13 (B7)
A2: U21.14 (B6)
A3: U21.15 (B5)
A4: U21.16 (B4)
CLK: U19.2, U19.4
D0: U20.12 (B8)
D1: U20.13 (B7)
D2: U20.14 (B6)
D3: U20.15 (B5)
D4: U20.16 (B4)
D5: U20.17 (B3)
D6: U20.18 (B2)
D7: U20.20 (B1)
Earth: J4.5, J4.6, J4.7, J4.8, J4.10, R13.1, R17.1, R25.1, R41.2, R44.2, R45.2, R46.2, R47.2, U18.1 (GND), U18.2 (VIO), U18.4 (DONE), U18.10 (GND), U18.42 (GND), U19.7 (GND), U19.12, U19.13, U20.11 (GND), U21.11 (GND)
LV: R42.1, R43.1, U18.9 (+3.3V), U20.2 (VCCA), U21.2 (VCCA)
LV1: R47.1
LV2: U18.44 (~IRQ-gpio20)
LV3: U18.5 (gpio41-~CS)
LV4: U18.3 (~RST)
unnamed: J4.1, R31.2, R32.2, R46.1
unnamed: J4.2, R23.2, R24.2, R45.1
unnamed: J4.3, R12.2, R16.2, R44.1
unnamed: J4.13, U18.28 (vga_hsync-gpio45)
unnamed: J4.14, U18.29 (vga_vsync-gpio48)
unnamed: R10.1, U18.43 (vga_B0-gpio10)
unnamed: R2.1, R10.2, R13.2
unnamed: R2.2, R11.1, R14.2
unnamed: R11.2, R12.1, R15.2
unnamed: R14.1, U18.40 (vga_B1-gpio12)
unnamed: R15.1, U18.39 (vga_B2-gpio21)
unnamed: R16.1, U18.38 (vga_B3-gpio13)
unnamed: R17.2, R18.2, R19.1
unnamed: R18.1, U18.37 (vga_G0-gpio19)
unnamed: R19.2, R20.2, R21.1
unnamed: R20.1, U18.36 (vga_G1-gpio18)
unnamed: R21.2, R22.2, R23.1
unnamed: R22.1, U18.35 (vga_G2-gpio11)
unnamed: R24.1, U18.34 (vga_G3-gpio09)
unnamed: R25.2, R26.2, R27.1
unnamed: R26.1, U18.33 (vga_R0-gpio06)
unnamed: R27.2, R28.2, R29.1
unnamed: R28.1, U18.32 (vga_R1-gpio44)
unnamed: R29.2, R30.2, R31.1
unnamed: R30.1, U18.31 (vga_R2-gpio04)
unnamed: R32.1, U18.30 (vga_R3-gpio03)
unnamed: R41.1, U21.20 (B1)
unnamed: R42.2, U21.10 (OE)
unnamed: R43.2, U20.10 (OE)
unnamed: U18.6 (gpio39-~WR), U21.3 (A2)
unnamed: U18.7 (gpio40-~RD), U21.4 (A3)
unnamed: U18.11 (gpio23-A4), U21.5 (A4)
unnamed: U18.12 (gpio25-A3), U21.6 (A5)
unnamed: U18.13 (gpio26-A2), U21.7 (A6)
unnamed: U18.14 (gpio27-A1), U21.8 (A7)
unnamed: U18.15 (gpio32-A0), U21.9 (A8)
unnamed: U18.16 (gpio35-clk12), U18.41 (clk12)
unnamed: U18.17 (gpio31-D7), U20.1 (A1)
unnamed: U18.18 (gpio37-D6), U20.3 (A2)
unnamed: U18.19 (gpio34-D5), U20.4 (A3)
unnamed: U18.20 (gpio43-D4), U20.5 (A4)
unnamed: U18.21 (gpio36-D3), U20.6 (A5)
unnamed: U18.22 (gpio42-D2), U20.7 (A6)
unnamed: U18.23 (gpio38-D1), U20.8 (A7)
unnamed: U18.24 (gpio28-D0), U20.9 (A8)
unnamed: U19.1, U19.8
unnamed: U19.3, U21.18 (B2)
unnamed: U19.6, U21.17 (B3)
R~W: U19.5, U19.9, U19.10
