rodlima78/rod6502/hw/video_dac.kicad_sch

## KiCad design hw/video_dac.kicad_sch (2023-06-03, an earlier design)

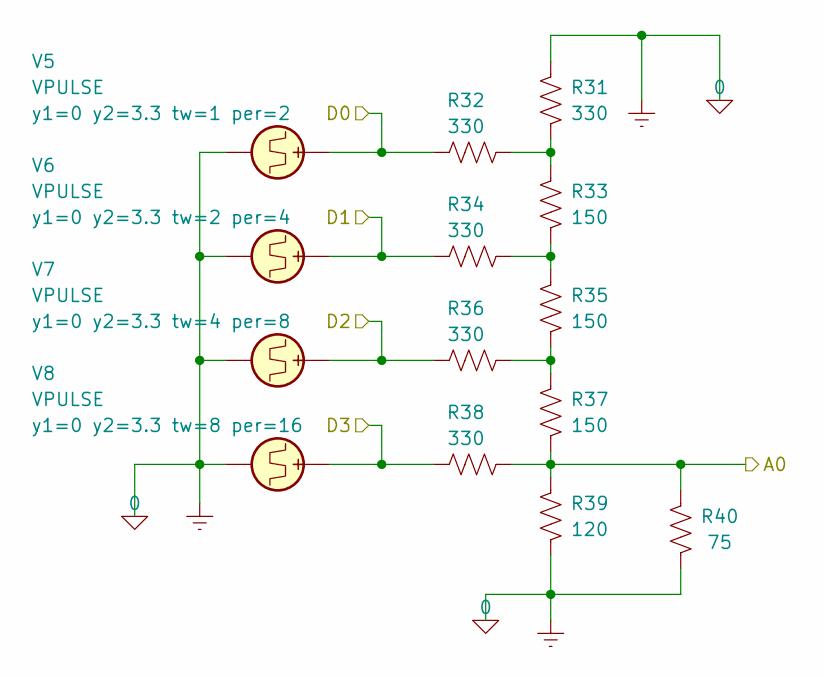
[picture p16: schematic video_dac.kicad_sch]

Parts:
R31, R32, R34, R36, R38: 330
R33, R35, R37: 150
R39: 120
R40: 75
V5, V6, V7, V8: VPULSE

Connections:
0: R31.2, R39.1, R40.1, V5.2, V6.2, V7.2, V8.2
A0: R37.1, R38.2, R39.2, R40.2
D0: R32.1, V5.1
D1: R34.1, V6.1
D2: R36.1, V7.1
D3: R38.1, V8.1
unnamed: R31.1, R32.2, R33.2
unnamed: R33.1, R34.2, R35.2
unnamed: R35.1, R36.2, R37.2
