rodlima78/rod6502/hw/clock/astable.kicad_sch

## KiCad design hw/clock/astable.kicad_sch (2023-03-20)

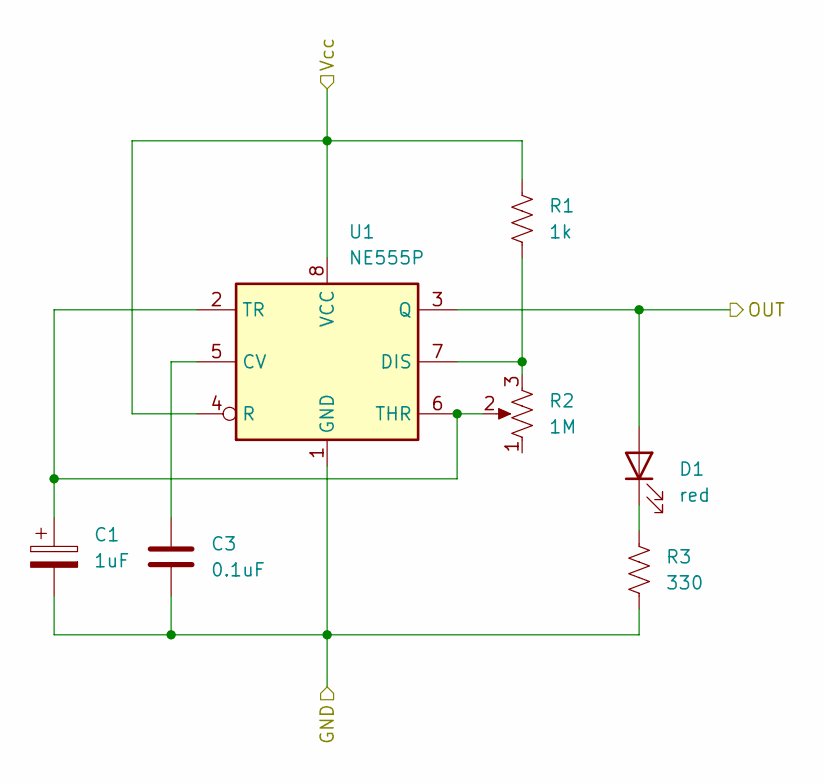
[picture p17: schematic astable.kicad_sch]

Parts:
C1: 1uF
C3: 0.1uF
D1: red
R1: 1k
R2: 1M
R3: 330
U1: NE555P; DIP-8_W7.62mm

Connections:
GND: C1.2, C3.1, R3.2, U1.1 (GND)
unnamed: C1.1, R2.2, U1.2 (TR), U1.6 (THR)
unnamed: C3.2, U1.5 (CV)
unnamed: D1.1 (K), R3.1
unnamed: R1.2, R2.3, U1.7 (DIS)
OUT: D1.2 (A), U1.3 (Q)
Vcc: R1.1, U1.4 (R), U1.8 (VCC)
