rodlima78/rod6502/hw/clock/bistable.kicad_sch

## KiCad design hw/clock/bistable.kicad_sch (2023-03-20)

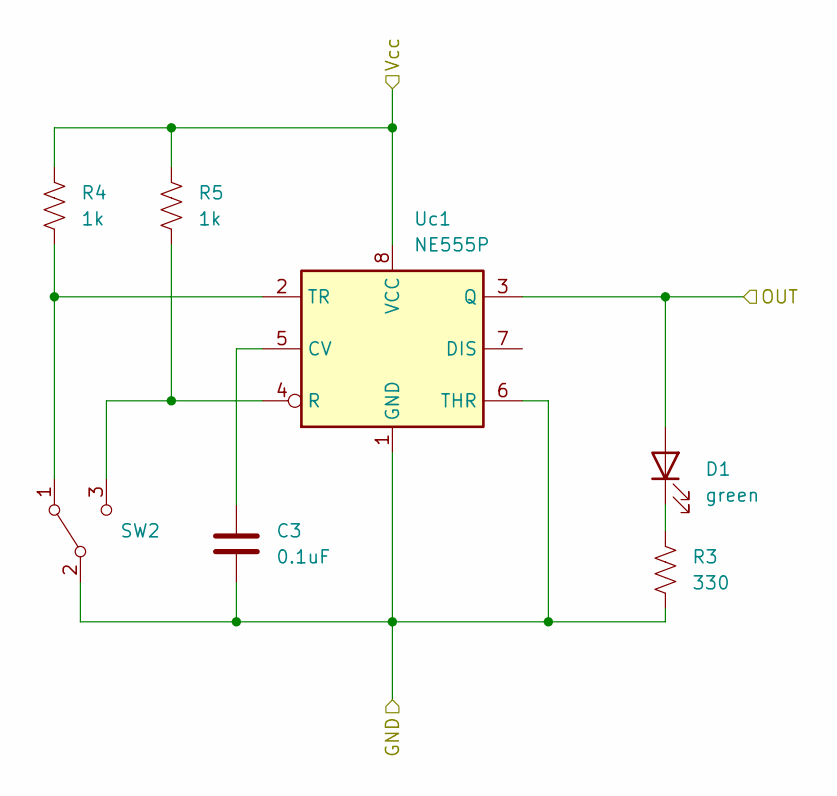
[picture p18: schematic bistable.kicad_sch]

Parts:
C3: 0.1uF
D1: green
R3: 330
R4, R5: 1k
SW2: SW_SPDT
Uc1: NE555P; DIP-8_W7.62mm

Connections:
GND: C3.1, R3.2, SW2.2 (B), Uc1.1 (GND), Uc1.6 (THR)
unnamed: C3.2, Uc1.5 (CV)
unnamed: D1.1 (K), R3.1
unnamed: R4.2, SW2.1 (A), Uc1.2 (TR)
unnamed: R5.2, SW2.3 (C), Uc1.4 (R)
OUT: D1.2 (A), Uc1.3 (Q)
Vcc: R4.1, R5.1, Uc1.8 (VCC)
