rodlima78/rod6502/hw/clock/clock.kicad_sch

## KiCad design hw/clock/clock.kicad_sch (2023-03-20)

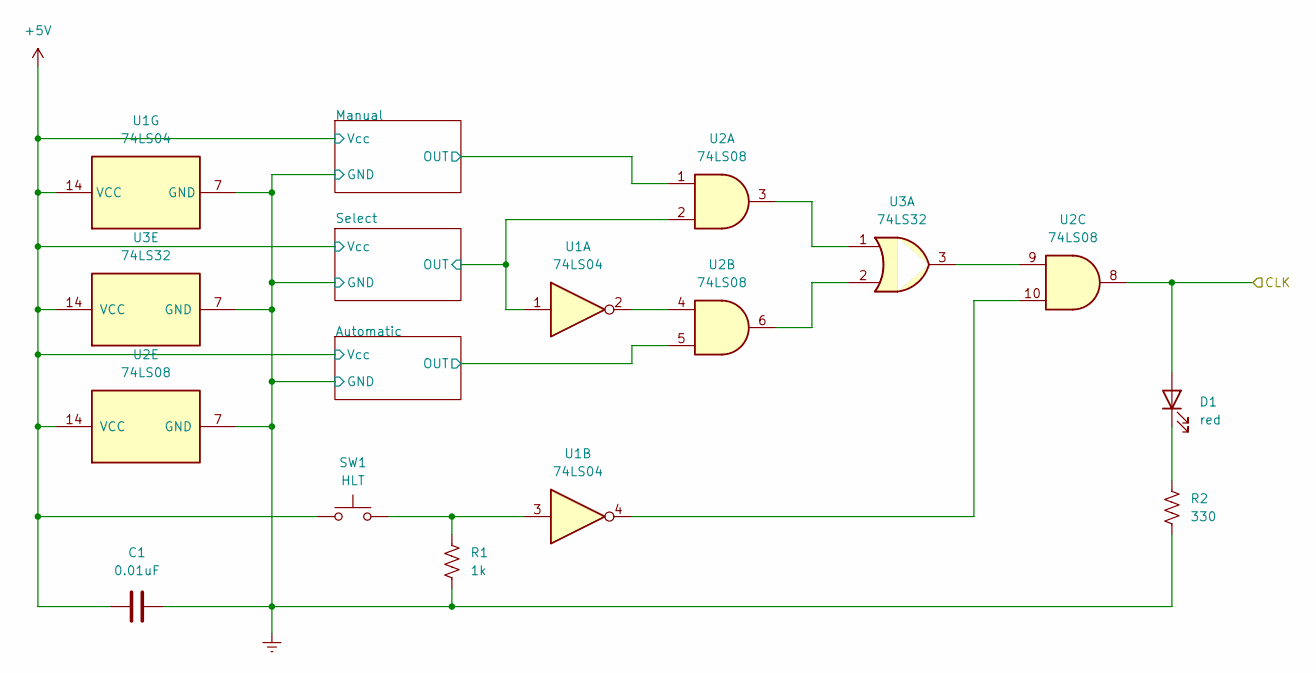
[picture p19: schematic clock.kicad_sch]

Parts:
C1: 0.01uF
D1: red
R1: 1k
R2: 330
SW1: HLT
U1: 74LS04
U2: 74LS08
U3: 74LS32

Connections:
+5V: C1.1, SW1.1, U1.14 (VCC), U2.14 (VCC), U3.14 (VCC)
CLK: D1.2 (A), U2.8
Earth: C1.2, R1.2, R2.2, U1.7 (GND), U2.7 (GND), U3.7 (GND)
unnamed: D1.1 (K), R2.1
unnamed: R1.1, SW1.2, U1.3
unnamed: U1.2, U2.4
unnamed: U1.4, U2.10
unnamed: U2.3, U3.1
unnamed: U2.6, U3.2
unnamed: U2.9, U3.3
OUT: U1.1, U2.1, U2.2, U2.5
