rodlima78/rod6502/hw/clock/monostable.kicad_sch

## KiCad design hw/clock/monostable.kicad_sch (2023-03-20)

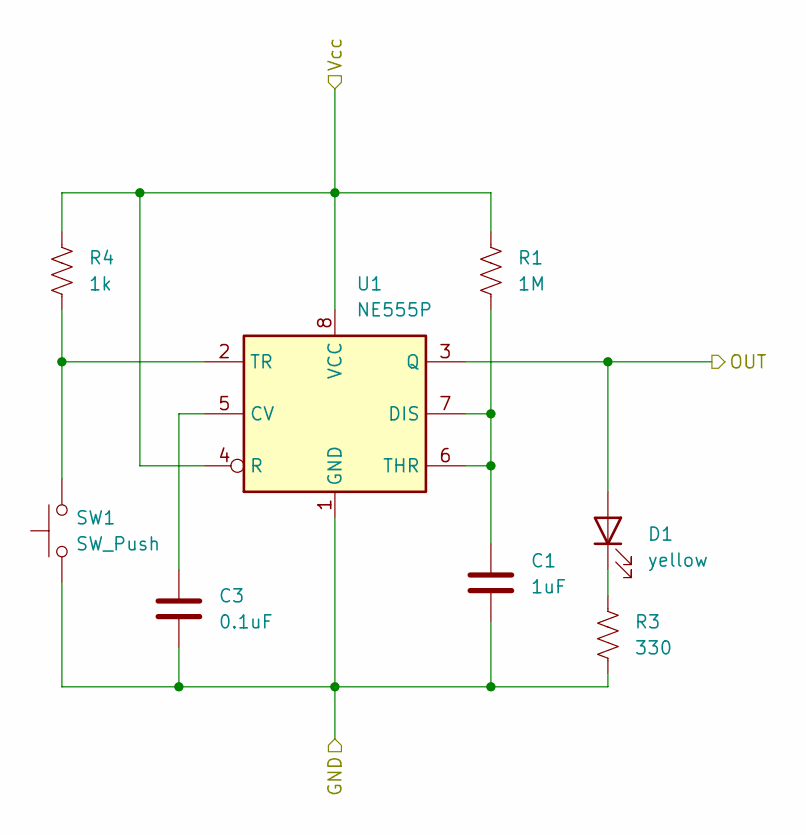
[picture p20: schematic monostable.kicad_sch]

Parts:
C1: 1uF
C3: 0.1uF
D1: yellow
R1: 1M
R3: 330
R4: 1k
SW1: SW_Push
U1: NE555P; DIP-8_W7.62mm

Connections:
GND: C1.2, C3.1, R3.2, SW1.1, U1.1 (GND)
unnamed: C1.1, R1.2, U1.6 (THR), U1.7 (DIS)
unnamed: C3.2, U1.5 (CV)
unnamed: D1.1 (K), R3.1
unnamed: R4.2, SW1.2, U1.2 (TR)
OUT: D1.2 (A), U1.3 (Q)
Vcc: R1.1, R4.1, U1.4 (R), U1.8 (VCC)
