rodlima78/rod6502/(commit log)

2023-03-20 initial commit
    included in kicad design:
    - 65c02!
    - memory 48k RAM, 14k ROM, 2k I/O
    - address decoding
    - lcd display
    - configurable irq priority
    - rs-232 comm
    - via i/o
    - led diplays for data and address
    includes arduino serial analyzer
    [ATF16V8B.step, addrdec.circ, addrdec.kicad_sch, address_display.kicad_sch, astable.kicad_sch, bistable.kicad_sch, clock.kicad_pcb, clock.kicad_sch]
2023-03-24 fix addrdec design bug, use ca65/cmake instead of vasm/make
    [addrdec.circ, addrdec.kicad_sch, firmware.cfg, irq.kicad_sch, rod6502.kicad_sch]
2023-03-24 add proper POST program
    tests for memory and VIA
    [lcd.kicad_sch]
2023-03-24 add address decoding timings
    [addrdec.kicad_sch, data_display.kicad_sch, irq.kicad_sch, rod6502.kicad_sch]
2023-03-25 fixed bugs in IRQ prio circuit
    POST pass
    [addrdec.kicad_sch, data_display.kicad_sch, irq.kicad_sch, irq_rw.circ, rod6502.kicad_sch]
2023-03-26 output POST status on lcd display
    [addrdec.kicad_sch, irq.kicad_sch]
2023-03-28 RS-232/ACIA works!
    [addrdec.kicad_sch, clock.kicad_sch, data_display.kicad_sch, firmware.cfg, io.kicad_sch, irq.kicad_sch, rod6502.kicad_sch, serialcomm.kicad_sch]
2023-03-28 adjust timings to fast IC for address decoding
    [addrdec.kicad_sch, irq.kicad_sch, rod6502.kicad_sch]
2023-04-03 add bios that only does post, set up IRQ infrastructure.
    [firmware_apps.cfg, firmware_bios.cfg]
2023-04-03 add hello application
    using binary format, not o65
    [firmware_apps.cfg]
2023-04-04 acia putchar and getchar works
    [firmware_bios.cfg, rod6502.kicad_sch]
2023-04-04 [acia] use interrupts to check for incoming data
2023-04-14 [bios] xmodem load works, hello app works!
    [firmware_apps.cfg, firmware_bios.cfg]
2023-04-14 [run] report error is app isn't loaded
    [firmware_apps.cfg, firmware_bios.cfg]
2023-04-19 can load o65 file that doesn't require relocation
    [firmware_apps.cfg]
2023-04-20 don't hardcode data seg size used bios in firmware_bios
    this allows bios to use data seg for more stuff
    [firmware_apps.cfg, firmware_bios.cfg]
2023-04-20 add sys_malloc
    now it's quite simple, as we don't have sys_free.
    [firmware_bios.cfg]
2023-04-20 use malloc to allocate memory for the segments of loaded app
    [firmware_apps.cfg]
2023-04-28 make xmodem lower in the stack, and o65 load on top of it
    Before it was the opposite, which doesn't make sense.
    [firmware_apps.cfg]
2023-04-28 Implement relocation of undefined references in text segment
    [firmware_apps.cfg]
2023-04-28 [o65] implement text, data, bss and zero-page relocation
    [firmware_apps.cfg]
2023-04-28 Bios exports lcd_printchar
    [firmware_apps.cfg]
2023-04-28 Add zeropage relocation
    BIOS now can use a chunk of zeropage during
    app run, useful for syscalls.
    zeropage used when no app is loaded doesn't take
    up space when app is run.
    [firmware_apps.cfg, firmware_bios.cfg]
2023-04-28 Read app entrypoint and jump to it
    App must export the "main" symbol
    [firmware_apps.cfg]
2023-05-03 WIP: add simple sys_malloc/sys_free
    [firmware_apps.cfg, firmware_bios.cfg]
2023-05-03 lcd_hex implemented in terms of io_hex
    io_hex is generic and accepts a put_char functor
    [firmware_apps.cfg]
2023-05-03 Implement acia_put_const_string in terms of the new io_put_const_string
    [firmware_apps.cfg]
2023-05-03 remove lcd_print/lcd_string and add lcd_put_const_string
    [firmware_apps.cfg]
2023-05-04 acia_get_char returns C==1 in case of errors
2023-05-04 add io_get_hex
    [firmware_apps.cfg]
2023-05-04 expose acia_get_bytes and acia_put_bytes
    [firmware_apps.cfg]
2023-05-05 add io_push/pop_put/get_byte and remove lcd/acia_put_const_string
    [firmware_apps.cfg]
2023-05-05 Add sys_abort function
    [firmware_apps.cfg]
2023-05-06 add acia_get_byte_timeout
    acia_get_byte now always has infinite timeout
    [firmware_apps.cfg]
2023-05-06 add io_get_pushback
    [firmware_apps.cfg]
2023-05-06 add io_get_skip_space
    we don't need cmdline_getback anymore
    [firmware_apps.cfg]
2023-05-06 [monitor] add "info heap" command
    [firmware_apps.cfg]
2023-05-06 add io_put_const_string_stack
    [firmware_apps.cfg]
2023-05-07 sys_malloc sets C==1 in case of errors
    it also preserves x,y and a
2023-05-11 [sys_malloc] handle case where empty segsize == size
    this avoids a segment pointing to itself
2023-05-16 Move hardware schematics to hw/
    [ATF16V8B.step, addrdec.circ, addrdec.kicad_sch, address_display.kicad_sch, astable.kicad_sch, bistable.kicad_sch, clock.kicad_pcb, clock.kicad_sch]
2023-05-23 add hw design for veraduino
    [addrdec.kicad_sch, clock.kicad_sch, ctrl_display.kicad_sch, irq.kicad_sch, lvlconv4.kicad_sch, rod6502.kicad_sch, rw_split.circ, serialcomm.kicad_sch]
2023-05-28 add hw schematics for video output with veraduino
    [addrdec.kicad_sch, address_display.kicad_sch, clock.kicad_sch, ctrl_display.kicad_sch, data_display.kicad_sch, io.kicad_sch, irq.kicad_sch, lcd.kicad_sch]
2023-06-03 clean up hw schematics
    [addrdec.kicad_sch, irq.kicad_sch, mem.kicad_sch, rod6502.kicad_sch, vera.kicad_sch.kicad_sch, video_dac.kicad_sch]
2023-06-03 [acia] simplify a bit rx interrupt handler code
    no perf hit, a few code bytes more, it's ok.
2024-11-21 track *.png using git-lfs
